megatops/ets2_lcd_dashboard/board.h

// ETS2 LCD Dashboard for ESP8266/ESP32C3
//
// Copyright (C) 2024-2026 Ding Zhaojie <zhaojie_ding@msn.com>
//
// This work is licensed under the terms of the GNU GPL, version 2 or later.
// See the COPYING file in the top-level directory.

#pragma once

#include <cstdint>

// 2004 LCD PCF8574 I2C address
constexpr int LCD_ADDR = 0x27;

// I2C IO pins
constexpr int I2C_SDA = 4;
constexpr int I2C_SCL = 5;

// LCD backlight control pin (PWM)
constexpr int LCD_LED_PWM = 2;

// WS2812 LED configuration
constexpr int RGB_LED_PIN = 0;
constexpr int RGB_LED_NUM = 8;  // the most common 8x WS2812 module

// Bus frequencies
constexpr int SERIAL_BAUDRATE = 2000000;  // 2Mb USB serial
constexpr uint32_t I2C_FREQ = 400000;     // 400kHz fast mode
