megatops/ets2_lcd_dashboard/config.h

// ETS2 LCD Dashboard for ESP8266/ESP32C3
//
// Copyright (C) 2024-2026 Ding Zhaojie <zhaojie_ding@msn.com>
//
// This work is licensed under the terms of the GNU GPL, version 2 or later.
// See the COPYING file in the top-level directory.

#pragma once

#include <cstdint>
#include "board.h"
#include "src/display/display.hpp"

constexpr bool DEBUG_ENABLE = false;  // verbose serial debug info

// Wi-Fi and API server
constexpr const char *SSID = "YOUR WIFI SSID";
constexpr const char *PASSWORD = "YOUR WIFI PASSWORD";
constexpr const char *ETS_API = "http://YOUR_PC_IP:25555/api/ets2/telemetry";

// Clock settings
constexpr bool CLOCK_ENABLE = true;                   // false to disable the clock feature
constexpr const char *NTP_SERVER = "pool.ntp.org";    // "ntp.ntsc.ac.cn" for mainland China
constexpr int TIME_ZONE = 8 * 60;                     // local time zone in minutes
constexpr bool DST = false;                           // daylight saving time

// Dashboard configurations
constexpr bool SHOW_MILE = false;   // display with mile instead of km
constexpr bool CLOCK_BLINK = true;  // blink the ":" mark in ETS2 dashboard clock
constexpr bool CLOCK_12H = true;    // display ETS2 dashboard clock in 12 hour

// Backlight levels
constexpr int BACKLIGHT_MAX = 255;
constexpr int BACKLIGHT_OFF = 0;

// Backlight levels for dashboard
constexpr int BACKLIGHT_DAY = 200;    // for daytime, brighter
constexpr int BACKLIGHT_NIGHT = 128;  // when headlight on, dimmer

// RGB bar brightness level
constexpr uint8_t RGB_LEVEL_DAY = 2;
constexpr uint8_t RGB_LEVEL_NIGHT = 2;
constexpr uint8_t RGB_LEVEL_OFF = 0;

// Backlight levels for clock
constexpr int BACKLIGHT_CLOCK = 128;     // normal time
constexpr int BACKLIGHT_CLOCK_DIM = 24;  // night light

// Hours to dim the clock (1:00am ~ 5:59am by default)
constexpr bool CLOCK_DIM_HOURS[24]{
  [0] = false,
  [1] = true,
  [2] = true,
  [3] = true,
  [4] = true,
  [5] = true,
  [6] = false,
  [7] = false,
  [8] = false,
  [9] = false,
  [10] = false,
  [11] = false,
  [12] = false,
  [13] = false,
  [14] = false,
  [15] = false,
  [16] = false,
  [17] = false,
  [18] = false,
  [19] = false,
  [20] = false,
  [21] = false,
  [22] = false,
  [23] = false,
};

// ETS2: electric truck models
constexpr const char *EV_TRUCKS[]{
  "E-Tech T",
  "S BEV",
  "XF Electric",
  nullptr,
};

// ETS2: fallback fuel capacity on data error (Iveco S-Way, etc.)
constexpr double DEFAULT_TANK_SIZE = 1200;

// Truck: LED indicators map
enum LedSlot {
  LBLINKER,
  AIR_WARN,
  BRAKE,
  LOW_BEAM,
  HIGH_BEAM,
  BEACON,
  PARK_BRAKE,
  RBLINKER,
  SLOT_MAX,
};
static_assert(LedSlot::SLOT_MAX <= RGB_LED_NUM, "Too many LED slots");

// Truck: LED indicator colors
constexpr RgbColor
  LED_ALERT{ 128, 0, 0 },   // red, half the brightness
  LED_WARN{ 128, 128, 0 },  // yellow
  LED_NOTICE{ 0, 0, 255 },  // blue (for high beam)
  LED_INFO{ 0, 128, 0 },    // green, half the brightness
  LED_OFF{ 0, 0, 0 };

// Forza: the car class to use performance dashboard style.
// 0:D 1:C 2:B 3:A 4:S1 5:S2 6:X ...
// Set to 0 to always use performance dashboard,
// Set to 10 to disable performance dashboard.
constexpr int FORZA_PRO_CLASS = 4;

// DiRT: there is no car class information, we can only select one style.
// Set to true to use performance dashboard,
// Set to false to use normal dashboard.
constexpr bool DIRT_PRO_STYLE = true;

// Racing: shift zone
constexpr float RACING_SHIFT_ZONE = 85.0;
constexpr float RACING_RED_ZONE = 90.0;

// Racing: shift indicator engine load map
constexpr float RGB_LOAD_MAP[RGB_LED_NUM]{
  40.0, 50.0, 60.0,                      // green
  70.0, 75.0, 80.0,                      // yellow
  RACING_SHIFT_ZONE, RACING_SHIFT_ZONE,  // red (shift zone)
};

// Racing: shift indicator color map
constexpr RgbColor RGB_COLOR_MAP[RGB_LED_NUM]{
  { 0, 255, 0 },  // green
  { 0, 255, 0 },
  { 0, 255, 0 },
  { 255, 255, 0 },  // yellow
  { 255, 255, 0 },
  { 255, 255, 0 },
  { 255, 0, 0 },  // red
  { 255, 0, 0 },
};
