megatops/ets2_lcd_dashboard/src/game/game.hpp

// ETS2 LCD Dashboard for ESP8266/ESP32C3
//
// Copyright (C) 2023-2026 Ding Zhaojie <zhaojie_ding@msn.com>
//
// This work is licensed under the terms of the GNU GPL, version 2 or later.
// See the COPYING file in the top-level directory.

#pragma once

#include <SoftwareTimer.h>
#include "../../config.h"
#include "../clock/ntp_clock.hpp"
#include "../display/display.hpp"

enum GameState {
  SERVER_DOWN,
  NOT_START,

  READY,
  DRIVING,  // driving the truck
};

class Game {
public:
  virtual ~Game() {}
  virtual const char *name() const;
  virtual GameState getTelemetry();
  virtual void freshDisplay(time_t time);
  virtual void start() {}
  virtual void stop() {}

public:
  const int MAX_FAILURE;   // max retries before idle
  const int ACTIVE_DELAY;  // data query interval in game (ms)

protected:
  explicit Game(int maxFailure, int activeDelay)
    : MAX_FAILURE(maxFailure), ACTIVE_DELAY(activeDelay) {}
};

class Controller {
public:
  Controller(NtpClock &clock, Game **games, size_t count);

  inline void tick() {
    timer_.tick();
  }

  inline void startGames() {
    for (size_t i = 0; i < gameCount_; i++) {
      games_[i]->start();
    }
  }

  inline void stopGames() {
    for (size_t i = 0; i < gameCount_; i++) {
      games_[i]->stop();
    }
  }

private:
  bool pollGame(Game &game);
  void pollGames();
  void realTimerCb();  // the actual timer cb
  void updateState();

private:
  NtpClock &clock_;
  SoftwareTimer timer_;

  Game **games_{};
  size_t gameCount_{};

  Game *active_{};  // current active game
  bool driving_{};
  GameState state_{ GameState::SERVER_DOWN };
  int failed_{};

private:
  static Controller *instance_;
  static void timerCb() {
    if (instance_ != nullptr) {
      instance_->realTimerCb();
    }
  }
};
