megatops/ets2_lcd_dashboard/(commit log)

2024-12-29 Move to ArduinoJson to support Mike's telemetry server fork
2026-02-16 Support ETS2/ATS LED indicators
2026-02-21 Support beacon and air pressure lights
2026-02-23 Supoort brake indicator
2026-03-01 Fix no clock mode
    [dashboard_ets2.cpp, dashboard_forza.cpp, ets2_lcd_dashboard.ino]
2026-05-14 Clean up formatting in Arduino CI workflow
    Remove unnecessary blank line before library installation step.
